AlfredoPaolino/SchivaTO/Schematic and PCB Layout/SCHIVATO.png

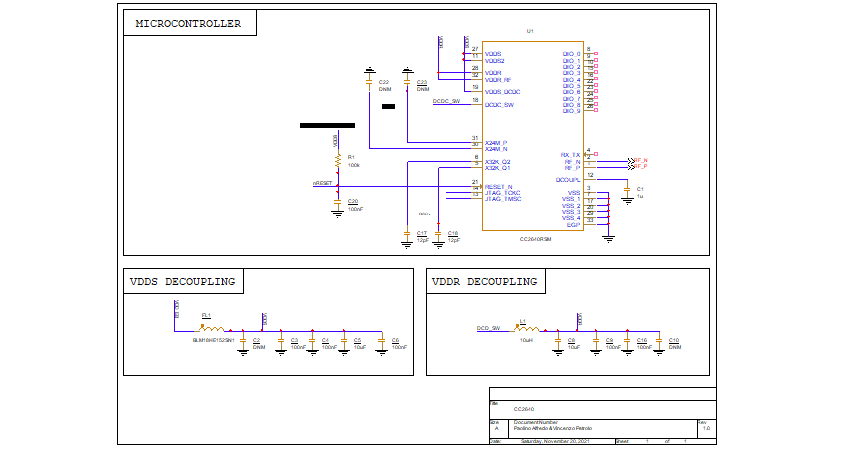
Schematic and PCB Layout/SCHIVATO.png
