AlfredoPaolino/SchivaTO/Technical Report/Pcitures/pcb_real_bottom.png

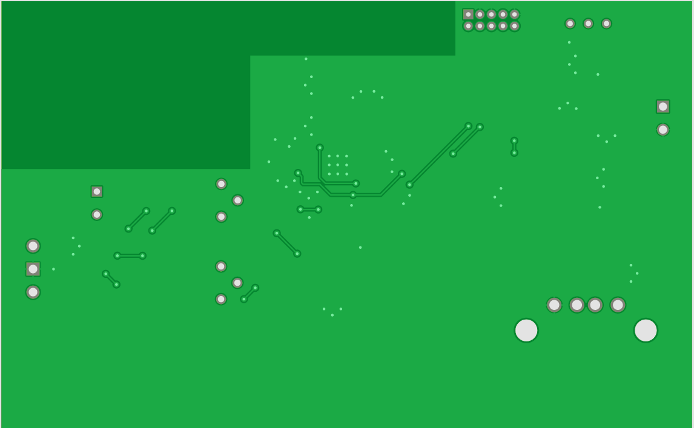
Technical Report/Pcitures/pcb_real_bottom.png
