AlfredoPaolino/SchivaTO/Technical Report/Pcitures/pcb_real_top.png

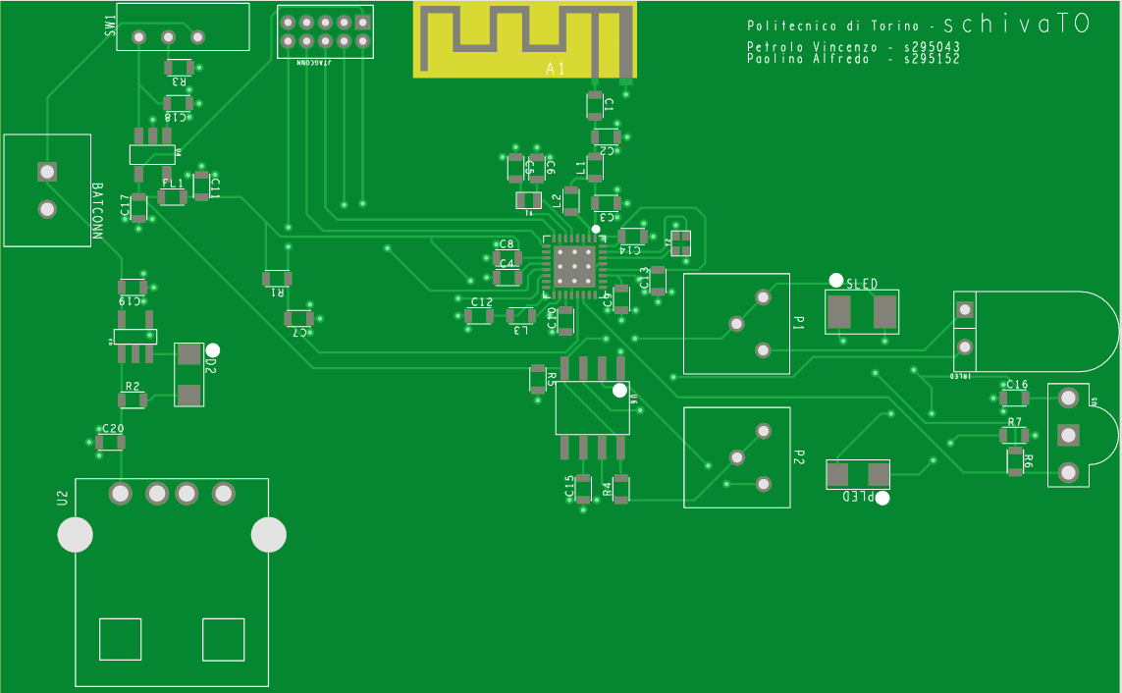
Technical Report/Pcitures/pcb_real_top.png
