AlfredoPaolino/SchivaTO/(list of files, cad)

Other CAD files:
Schematic and PCB Layout/FootprintLibrary/0603capacitors.psm
Schematic and PCB Layout/FootprintLibrary/0603ferrite.psm
Schematic and PCB Layout/FootprintLibrary/0603impedance.psm
Schematic and PCB Layout/FootprintLibrary/0603resistors.psm
Schematic and PCB Layout/FootprintLibrary/3362hxx.psm
Schematic and PCB Layout/FootprintLibrary/a1hsw6.psm
Schematic and PCB Layout/FootprintLibrary/aa3021lzgsk.psm
Schematic and PCB Layout/FootprintLibrary/aa3528sesk.psm
Schematic and PCB Layout/FootprintLibrary/aa3528sgs.psm
Schematic and PCB Layout/FootprintLibrary/cc2640.psm
Schematic and PCB Layout/FootprintLibrary/hs0038b3vm.psm
Schematic and PCB Layout/FootprintLibrary/iqxc-26.psm
Schematic and PCB Layout/FootprintLibrary/iqxc-90.psm
Schematic and PCB Layout/FootprintLibrary/iqxc_26.psm
Schematic and PCB Layout/FootprintLibrary/ir333a.psm
Schematic and PCB Layout/FootprintLibrary/jst-xh2p-st.psm
Schematic and PCB Layout/FootprintLibrary/jtagconn.psm
Schematic and PCB Layout/FootprintLibrary/m50-3600542.psm
Schematic and PCB Layout/FootprintLibrary/maxim1555.psm
Schematic and PCB Layout/FootprintLibrary/ne555dr.psm
Schematic and PCB Layout/FootprintLibrary/patchantenna.psm
Schematic and PCB Layout/FootprintLibrary/ss3-h.psm
Schematic and PCB Layout/FootprintLibrary/tlv70212dbvr.psm
Schematic and PCB Layout/FootprintLibrary/tlvxx.psm
