AlfredoPaolino/SchivaTO/(list of files, drawings)

Other design files:
Schematic and PCB Layout/allegro/SCHIVATO.dsn
Schematic and PCB Layout/LIBRARY1.OLB
Schematic and PCB Layout/POWERMANAGEMENTLIB.OLB
Schematic and PCB Layout/SCHIVATO.DSN
Schematic and PCB Layout/SchivaTO.opj
Schematic and PCB Layout/SCHIVATOLIBRARY.OLB
Schematic and PCB Layout/ul_CC2640F128RSMR/OrcadCaptureXML/2021-11-20_17-38-21.OLB
Schematic and PCB Layout/ul_CC2640F128RSMR/OrcadCaptureXML/2021-11-20_17-38-21.opj
